saiswaroopnagavolu/ASCEND-UAV-Autonomous-Charging-Station/base_station_hardware.jpeg

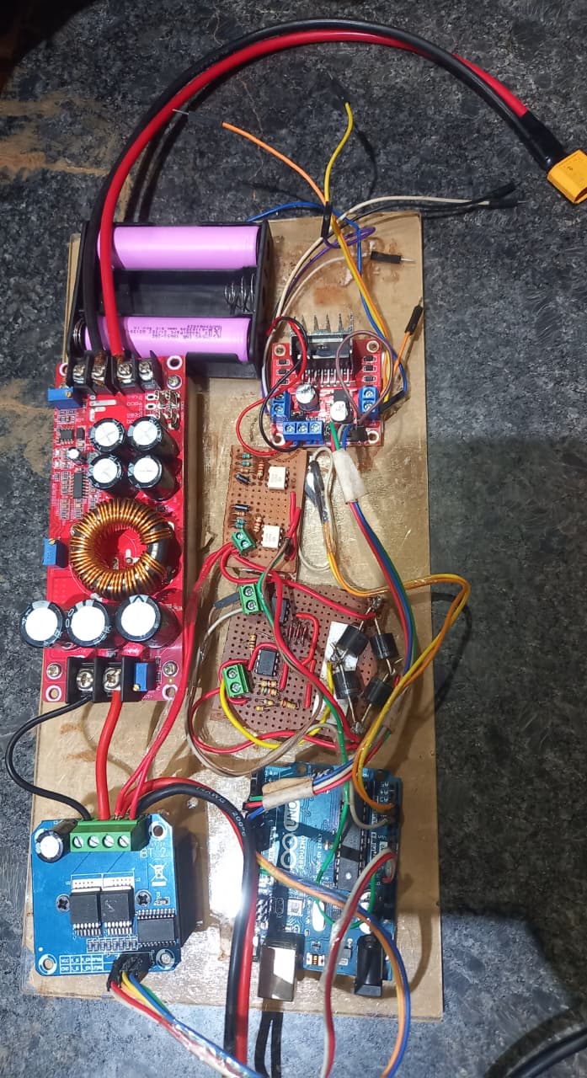
base_station_hardware.jpeg
