saiswaroopnagavolu/ASCEND-UAV-Autonomous-Charging-Station/(commit log)

2026-08-31 Revise README for ASCEND UAV Charging Station
    Updated project description, overview, objectives, charging architecture, and added detailed sections on polarity detection, H-bridge control, mechanical docking, microcontroller firmware, safety, testing, and project context.
2026-08-31 Cleanup README by removing circuit and demo sections
    Removed sections about the circuit diagram and demonstration from the README.
